Ibrashige/Sunstation/Research/Early PCB Design & Schematics/Base model Design & Schematics/PCB_Final base model copy_2020-09-08_11-15-57.png

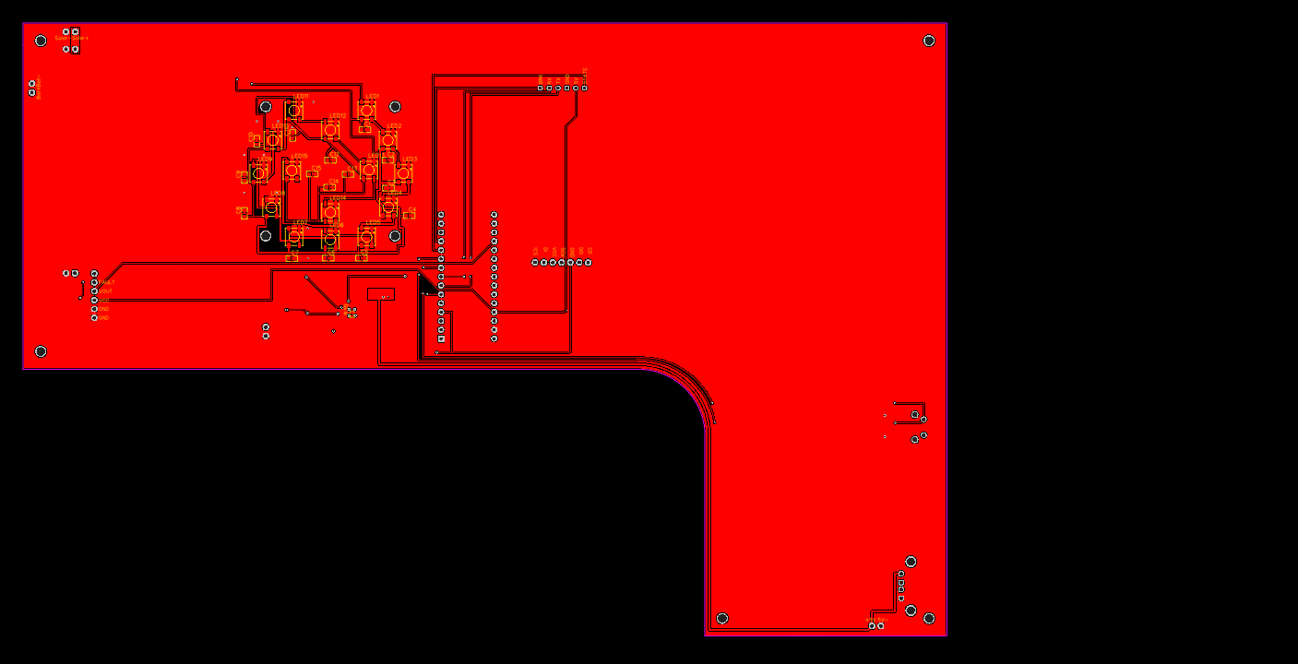
Research/Early PCB Design & Schematics/Base model Design & Schematics/PCB_Final base model copy_2020-09-08_11-15-57.png
