Ibrashige/Sunstation/Research/Early PCB Design & Schematics/Base model Design & Schematics/PCB_Final base model copy_2020-09-08_11-16-11.png

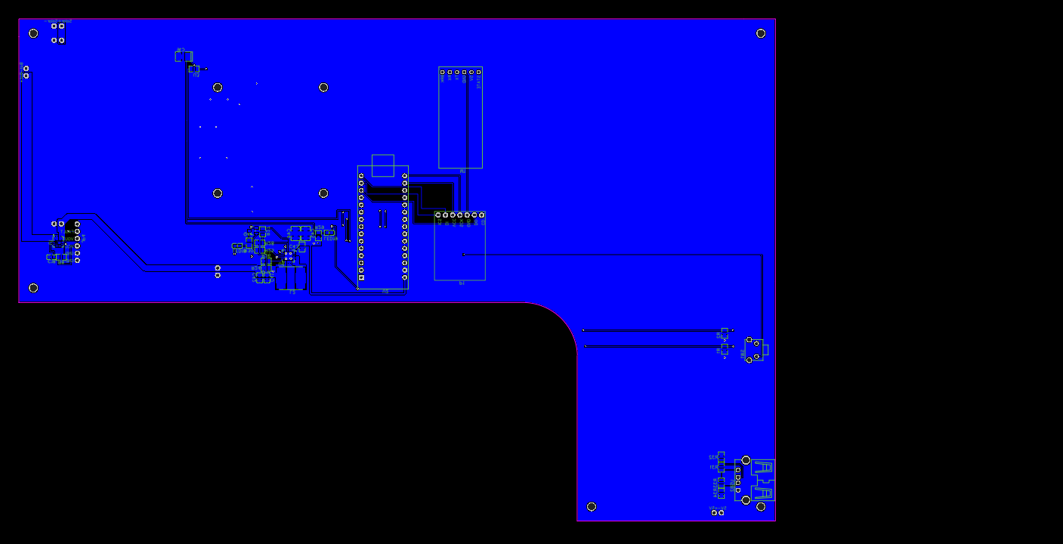
Research/Early PCB Design & Schematics/Base model Design & Schematics/PCB_Final base model copy_2020-09-08_11-16-11.png
