Ibrashige/Sunstation/Research/Early PCB Design & Schematics/Base model Design & Schematics/Schematic_Final base model_2020-09-08_11-15-40.png

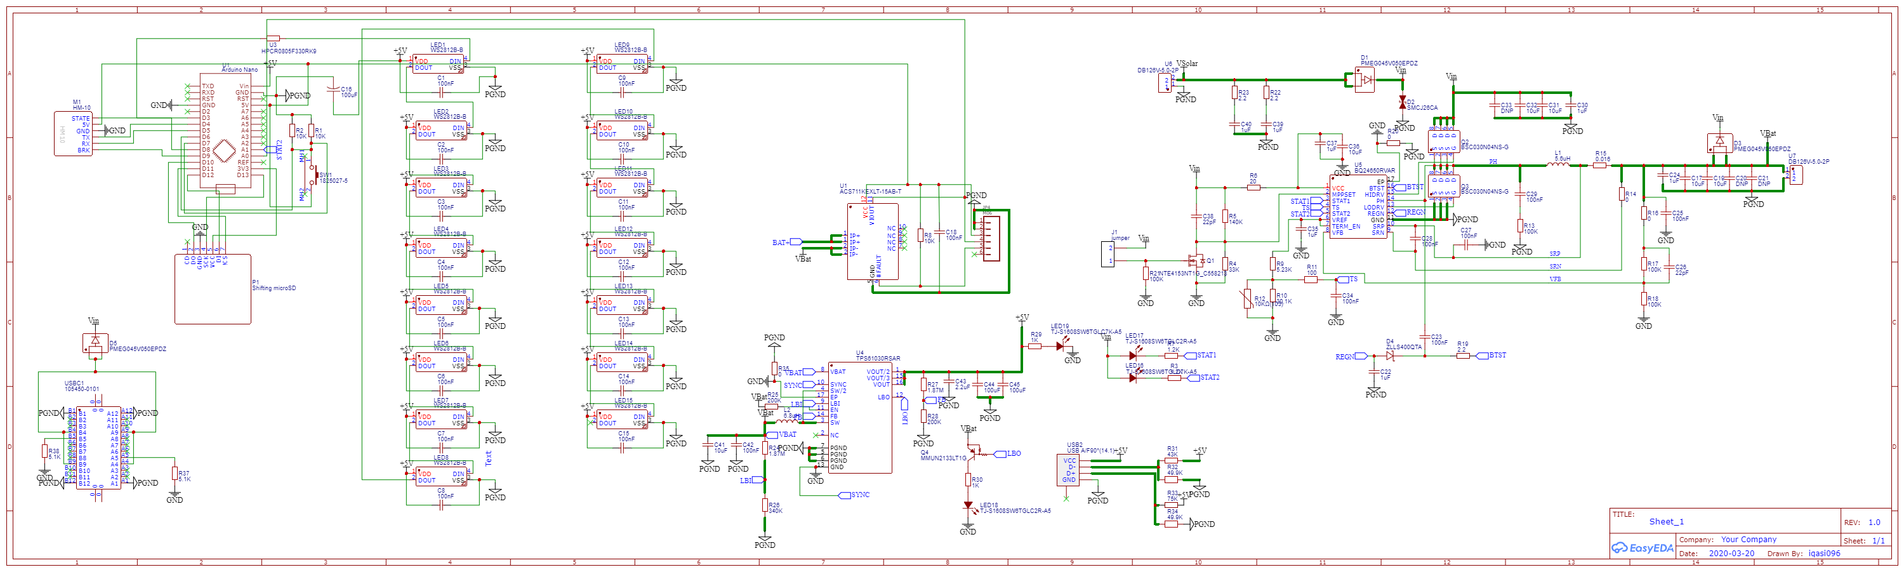
Research/Early PCB Design & Schematics/Base model Design & Schematics/Schematic_Final base model_2020-09-08_11-15-40.png
