Ibrashige/Sunstation/Research/Early PCB Design & Schematics/LED Display  Design & Schematics/PCB_6 segment sunstation PCB copy copy_2020-09-08_11-02-25.png

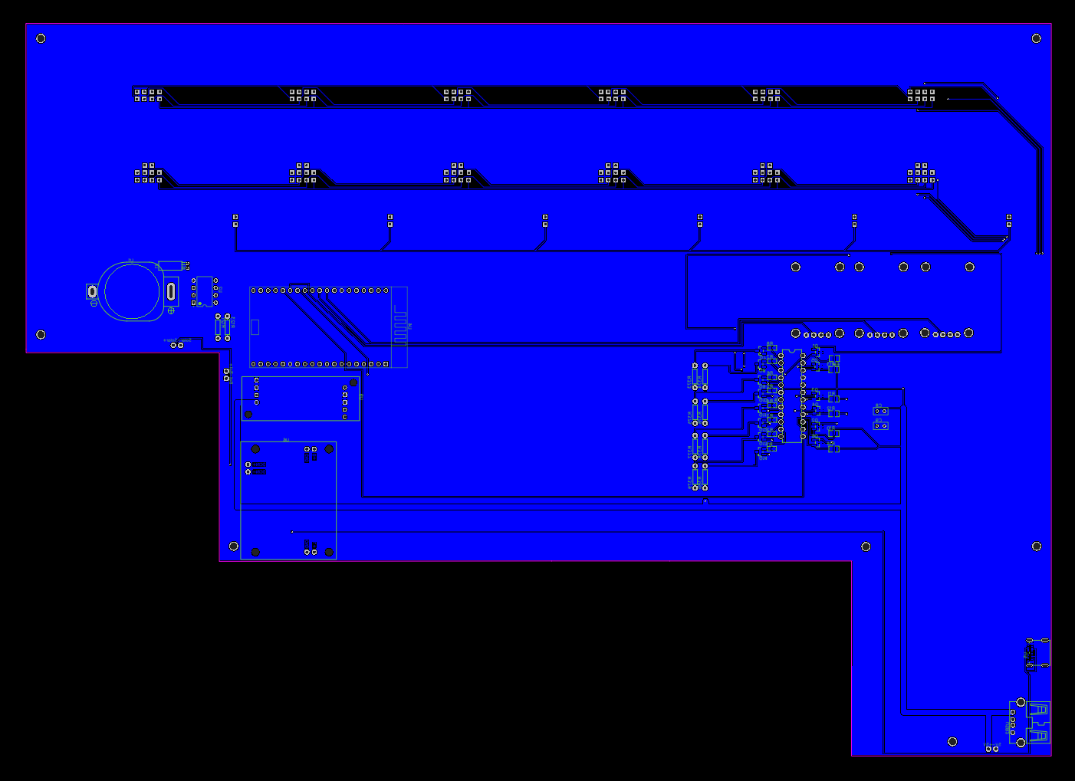
Research/Early PCB Design & Schematics/LED Display Design & Schematics/PCB_6 segment sunstation PCB copy copy_2020-09-08_11-02-25.png
