Ibrashige/Sunstation/Research/Early PCB Design & Schematics/LED Display  Design & Schematics/Schematic_LED mock up_2020-09-08_11-03-54.png

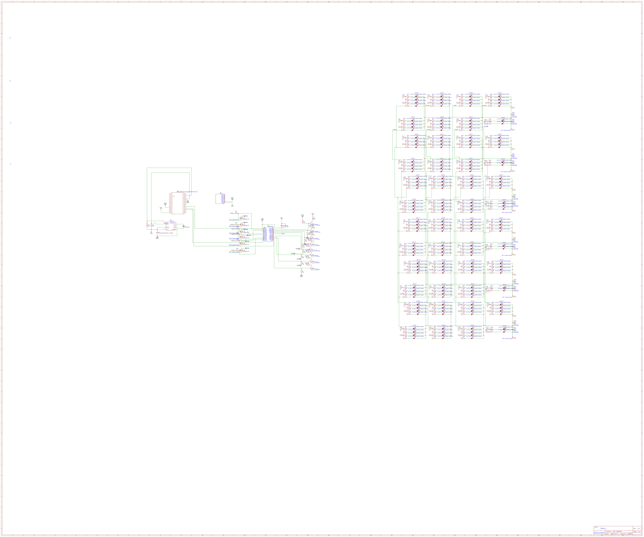
Research/Early PCB Design & Schematics/LED Display Design & Schematics/Schematic_LED mock up_2020-09-08_11-03-54.png
