Ibrashige/Sunstation/Research/Early PCB Design & Schematics/Power Electronics Design & Schematics/PCB_Sunstation Board copy_2020-09-08_11-18-07.png

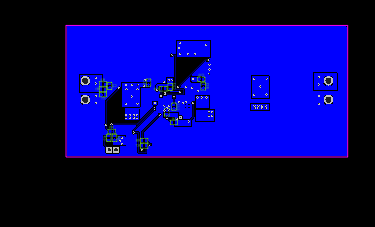
Research/Early PCB Design & Schematics/Power Electronics Design & Schematics/PCB_Sunstation Board copy_2020-09-08_11-18-07.png
