Ibrashige/Sunstation/Research/Early PCB Design & Schematics/Power Electronics Design & Schematics/Schematic_Fixed BQ24650EVM_2020-09-08_11-17-46.png

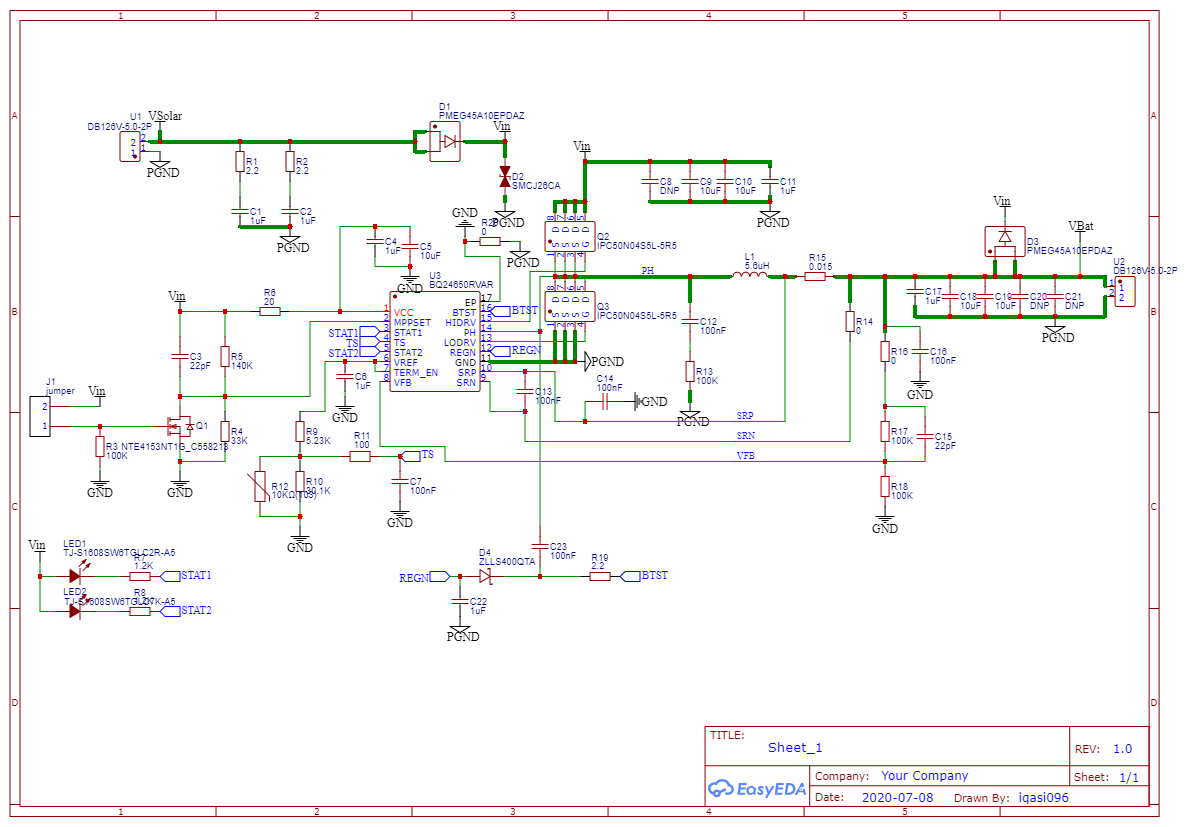
Research/Early PCB Design & Schematics/Power Electronics Design & Schematics/Schematic_Fixed BQ24650EVM_2020-09-08_11-17-46.png
