Ibrashige/Sunstation/Research/LED Display Research/12 Digit 7 segment LED Display/12digit_7segment.PNG

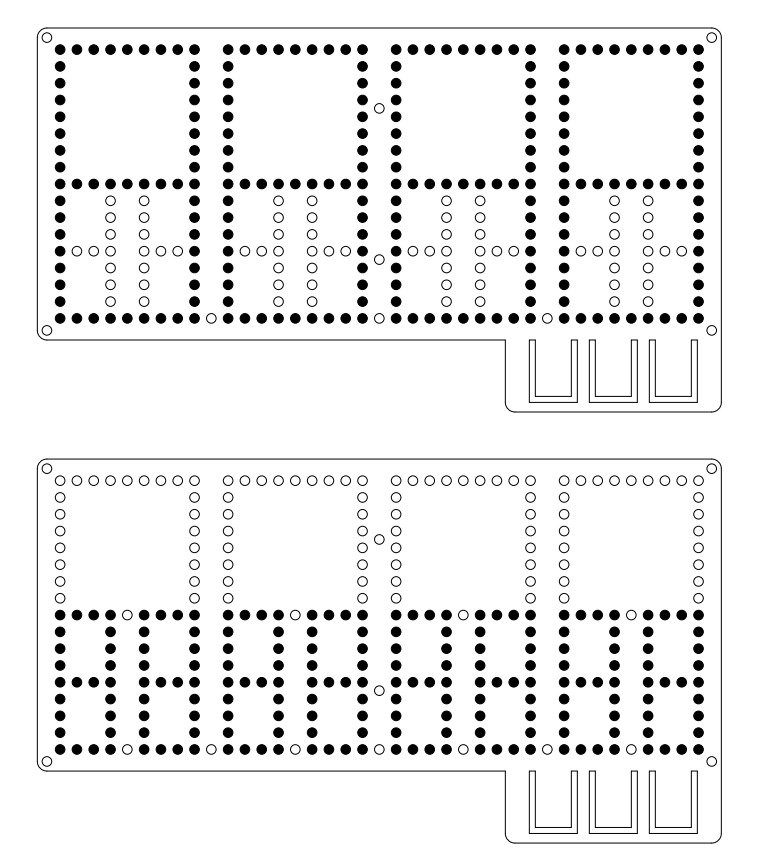
Research/LED Display Research/12 Digit 7 segment LED Display/12digit_7segment.PNG
