Ibrashige/Sunstation/Research/LED Display Research/Single 7 segment Digit LED Display/binary_representation.jpg

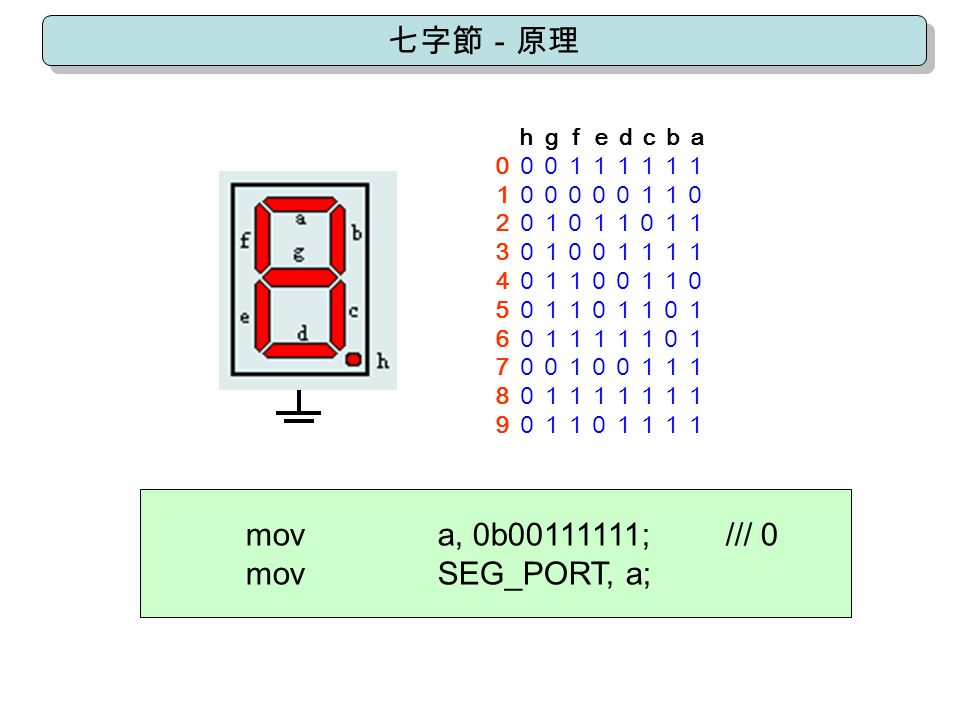
Research/LED Display Research/Single 7 segment Digit LED Display/binary_representation.jpg
