Ibrashige/Sunstation/Research/LED Display Research/Single 7 segment Digit LED Display/digits.jpg

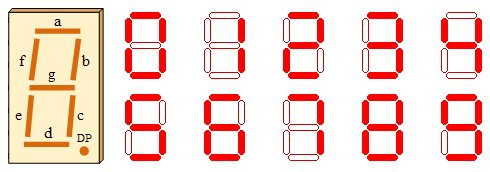
Research/LED Display Research/Single 7 segment Digit LED Display/digits.jpg
