Ibrashige/Sunstation/BOM CPL & Gerbers/Base Model/BOM_Final base model_2021-08-13.csv.xlsx

ID | Name | Designator | Footprint | Quantity | Manufacturer Part | Manufacturer | Supplier | Supplier Part | Price | Links
1 | 100nF | C1,C2,C3,C4,C5,C6,C7,C8,C9,C10,C11,C12,C13,C14,C15,C18 | C0603 | 16 | C0603C104K5RACAUTO | KEMET | LCSC | C129621 | $0.01 | https://lcsc.com/product-detail/Multilayer-Ceramic-Capacitors-MLCC-SMD-SMT_KEMET-C0603C104K5RACAUTO_C129621.html
2 | 100uF | C16 | CAP-SMD_L3.5-W2.8 | 1 | CA45-B-10V-100uF-M | Shenzhen Zhenhua XinYun Elec | LCSC | C140381 | $0.30 | https://lcsc.com/product-detail/Tantalum-Capacitors_CEC-Shenzhen-Zhenhua-XinYun-Elec-CA45-B-10V-100uF-M_C140381.html
3 | 10uF | C17,C19,C31,C32,C36 | C0402 | 5 | GRM155R61A106ME21D | Murata Electronics | LCSC | C324476 | $0.02 | https://lcsc.com/product-detail/Multilayer-Ceramic-Capacitors-MLCC-SMD-SMT_Murata-Electronics-GRM155R61A106ME21D_C324476.html
4 | DNP | C20,C21,C33 | C0402 | 3 | GRM155R61A106ME21D | Murata Electronics | LCSC | C324476 | $0.02
5 | 1uF | C22,C24,C30,C35,C37,C39,C40 | C0402 | 7 | 0402B105K100NT | FH | LCSC | C1526 | $0.003 | https://lcsc.com/product-detail/Multilayer-Ceramic-Capacitors-MLCC-SMD-SMT_FH-Guangdong-Fenghua-Advanced-Tech-0402B105K100NT_C1526.html
6 | 100nF | C23,C25,C27,C28,C29,C34 | C0402 | 6 | GRM155R71C104KA88D | MuRata | LCSC | C71629 | $0.002 | https://lcsc.com/product-detail/Multilayer-Ceramic-Capacitors-MLCC-SMD-SMT_Murata-Electronics-GRM155R71C104KA88D_C71629.html
7 | 22pF | C26,C38 | C0402 | 2 | GRM1555C1H220JA01D | MuRata | LCSC | C76960 | $0.004 | https://lcsc.com/product-detail/Multilayer-Ceramic-Capacitors-MLCC-SMD-SMT_Murata-Electronics-GRM1555C1H220JA01D_C76960.html
8 | 100nF | C51 | C0603 | 1 | AC0603KRX7R9BB104 | YAGEO | LCSC | C149620 | $0.01 | https://lcsc.com/product-detail/Multilayer-Ceramic-Capacitors-MLCC-SMD-SMT_YAGEO-AC0603KRX7R9BB104_C149620.html
9 | B2P-VH-FB-B-(LF)(SN) | CN1 | CONN-TH_2P-P3.96_B2P-VH-FB-B(LF)(SN) | 1 | B2P-VH-FB-B-(LF)(SN) | JST Sales America | LCSC | C158006 | $0.14 | https://lcsc.com/product-detail/Wire-To-Board-Wire-To-Wire-Connector_JST-Sales-America-B2P-VH-FB-B-LF-SN_C158006.html
10 | PMEG45A10EPDAZ | D1,D3 | SOT1289_L5.8-W4.4-LS6.5-RD | 2 | PMEG45A10EPDAZ | Nexperia | LCSC | C458256 | $0.83 | https://lcsc.com/product-detail/Schottky-Barrier-Diodes-SBD_Nexperia-PMEG45A10EPDAZ_C458256.html
11 | SMCJ26CA | D2 | SMC_L6.9-W5.9-LS7.9-BI | 1 | SMCJ26CA | RUILON | LCSC | C10244 | $0.21 | https://lcsc.com/product-detail/TVS_RUILON-Shenzhen-Ruilongyuan-Elec-SMCJ26CA_C10244.html
12 | ZLLS400QTA | D4 | SOD-323_L1.8-W1.3-LS2.5-RD | 1 | ZLLS400QTA | DIODES | LCSC | C151560 | $0.23 | https://lcsc.com/product-detail/Schottky-Barrier-Diodes-SBD_Diodes-Incorporated-ZLLS400QTA_C151560.html
13 | 5.6uH | L1 | IND-SMD_L11.5-W10.0_APS10A40 | 1 | APS10A40M5R6 | COILANK INTERNATIONAL | LCSC | C253624 | $0.29 | https://lcsc.com/product-detail/Power-Inductors_COILANK-INTERNATIONAL-APS10A40M5R6_C253624.html
14 | WS2812B-B | LED1,LED2,LED3,LED4,LED5,LED6,LED7,LED8,LED9,LED10,LED11,LED12,LED13,LED14 | LED-SMD_4P-L5.0-W5.0-BL | 14 | WS2812B-B | Worldsemi | LCSC | C114586 | $0.11 | https://lcsc.com/product-detail/Light-Emitting-Diodes-LED_Worldsemi-WS2812B-B_C114586.html
15 | WS2812B-B | LED15 | LED-SMD_4P-L5.0-W5.0-BL | 1 | WS2812B-B | Worldsemi | LCSC | C114586 | $0.11 | https://lcsc.com/product-detail/Light-Emitting-Diodes-LED_Worldsemi-WS2812B-B_C114586.html
16 | TJ-S1608SW6TGLC7K-A5 | LED16 | LED0603-R-RD | 1 | TJ-S1608SW6TGLC7K-A5 | TOGIALED | LCSC | C192666 | $0.03 | https://lcsc.com/product-detail/Light-Emitting-Diodes-LED_TOGIALED-TJ-S1608SW6TGLC7K-A5_C192666.html
17 | HL-798H256WC-MD_TC=6500K | LED17 | LED-TH_BD5.8-P2.54-R-RD | 1 | HL-798H256WC-MD_TC=6500K | HONGLITRONIC(Hongli Zhihui (HONGLITRONIC)) | LCSC | C568949 | $0.07 | https://lcsc.com/product-detail/Light-Emitting-Diodes-LED_HONGLITRONIC-Hongli-Zhihui-HONGLITRONIC-HL-798H256WC-MD_TC-6500K_C568949.html
18 | HM-10 | M1 | HM-10-MODULE | 1 |  |  |  | undefined
19 | NTE4153NT1G_C558213 | Q1 | SC-75-3_L1.6-W0.8-P1.00-LS1.6-BR | 1 | NTE4153NT1G | VBsemi Elec | LCSC | C558213 | $0.06 | https://lcsc.com/product-detail/MOSFETs_VBsemi-Elec-NTE4153NT1G_C558213.html
20 | IPC50N04S5L-5R5 | Q2,Q3 | PG-TDSON-8-FL_L5.0-W6.0-P1.27-LS6.2-BL | 2 | IPC50N04S5L-5R5 | Infineon Technologies | LCSC | C536703 | $1.03 | https://lcsc.com/product-detail/MOSFETs_Infineon-Technologies-IPC50N04S5L-5R5_C536703.html
21 | VBM2610N | Q4,Q5 | ITO-220AB-3_L10.2-W4.5-P2.60-L | 2 | VBM2610N | VBsemi Elec | LCSC | C481026 | $0.56 | https://lcsc.com/product-detail/MOSFETs_VBsemi-Elec-VBM2610N_C481026.html
22 | 10K | R1,R2,R8,R25,R26 | R0805 | 5 | CR0805J80103G | LIZ | LCSC | C101926 | $0.002 | https://lcsc.com/product-detail/Chip-Resistor-Surface-Mount_LIZ-Elec-CR0805J80103G_C101926.html
23 | 1.2K | R3,R7 | R0402 | 2 | AC0402FR-071K2L | YAGEO | LCSC | C144793 | $0.001 | https://lcsc.com/product-detail/Chip-Resistor-Surface-Mount_YAGEO-AC0402FR-071K2L_C144793.html
24 | 33K | R4 | R0402 | 1 | AC0402FR-0733KL | YAGEO | LCSC | C138291 | $0.001 | https://lcsc.com/product-detail/Chip-Resistor-Surface-Mount_YAGEO-AC0402FR-0733KL_C138291.html
25 | 140K | R5 | R0402 | 1 | RC0402FR-07140KL | YAGEO | LCSC | C114151 | $0.001 | https://lcsc.com/product-detail/Chip-Resistor-Surface-Mount_YAGEO-RC0402FR-07140KL_C114151.html
26 | 20 | R6 | R0402 | 1 | CR0402FF20R0G | LIZ | LCSC | C100299 | $0.001 | https://lcsc.com/product-detail/Chip-Resistor-Surface-Mount_LIZ-Elec-CR0402FF20R0G_C100299.html
27 | 5.23K | R9 | R0402 | 1 | 0402WGF5231TCE | UniOhm | LCSC | C25907 | $0.001 | https://lcsc.com/product-detail/Chip-Resistor-Surface-Mount_UNI-ROYAL-Uniroyal-Elec-0402WGF5231TCE_C25907.html
28 | 30.1K | R10 | R0402 | 1 | 0402WGF3012TCE | UniOhm | LCSC | C29402 | $0.001 | https://lcsc.com/product-detail/Chip-Resistor-Surface-Mount_UNI-ROYAL-Uniroyal-Elec-0402WGF3012TCE_C29402.html
29 | 100 | R11 | R0402 | 1 | 0402WGD1000TCE | Uniroyal Elec | LCSC | C407755 | $0.003 | https://lcsc.com/product-detail/Chip-Resistor-Surface-Mount_UNI-ROYAL-Uniroyal-Elec-0402WGD1000TCE_C407755.html
30 | 10KΩ | R12 | RES-TH_L8.0-W2.8-P2.54-D0-6 | 1 | NTCLE101E3C90173 | VISHAY | LCSC | C143692 | $1.74 | https://lcsc.com/product-detail/NTC-Thermistors_Vishay-Intertech-NTCLE101E3C90173_C143692.html
31 | 100K | R13,R17,R18,R21 | R0402 | 4 | AC0402FR-07100KL | YAGEO | LCSC | C144809 | $0.001 | https://lcsc.com/product-detail/Chip-Resistor-Surface-Mount_YAGEO-AC0402FR-07100KL_C144809.html
32 | 0 | R14,R16,R20 | R0402 | 3 | RC0402JR-070RL | YAGEO | LCSC | C60485 | $0.001 | https://lcsc.com/product-detail/Chip-Resistor-Surface-Mount_YAGEO-RC0402JR-070RL_C60485.html
33 | 0.015 | R15 | R1210 | 1 | CR1210F0R015P05 | Ever Ohms Tech | LCSC | C147206 | $0.03 | https://lcsc.com/product-detail/Current-Sense-Resistors-Shunt-Resistors_Ever-Ohms-Tech-CR1210FR015P05Z_C147206.html
34 | 2.2 | R19,R22,R23 | R0402 | 3 | 0402WGF220KTCE | UniOhm | LCSC | C25101 | $0.001 | https://lcsc.com/product-detail/Chip-Resistor-Surface-Mount_UNI-ROYAL-Uniroyal-Elec-0402WGF220KTCE_C25101.html
35 | 10M | R24 | R1206 | 1 | 1206W4F1005T5E | UniOhm | LCSC | C26119 | $0.01 | https://lcsc.com/product-detail/Chip-Resistor-Surface-Mount_UNI-ROYAL-Uniroyal-Elec-1206W4F1005T5E_C26119.html
36 | 43K | R31 | R0805 | 1 | WR08X4302FTL | WTC | LCSC | C168454 | $0.01 | https://lcsc.com/product-detail/Chip-Resistor-Surface-Mount_Walsin-Tech-Corp-WR08X4302FTL_C168454.html
37 | 49.9K | R32,R34 | R0805 | 2 | ERJ6ENF4992V | PANASONIC | LCSC | C416856 | $0.01 | https://lcsc.com/product-detail/Chip-Resistor-Surface-Mount_PANASONIC-ERJ6ENF4992V_C416856.html
38 | 75K | R33 | R0805 | 1 | 0805W8F7502T5E | UniOhm | LCSC | C17819 | $0.003 | https://lcsc.com/product-detail/Chip-Resistor-Surface-Mount_UNI-ROYAL-Uniroyal-Elec-0805W8F7502T5E_C17819.html
39 | 154K | R37 | R0603 | 1 | ERJ3EKF1543V | PANASONIC | LCSC | C403000 | $0.01 | https://lcsc.com/product-detail/Chip-Resistor-Surface-Mount_PANASONIC-ERJ3EKF1543V_C403000.html
40 | 21.3K | R46 | R0603 | 1 | CR0603-FX-2102ELF | BOURNS | LCSC | C203401 | $0.01 | https://lcsc.com/product-detail/Chip-Resistor-Surface-Mount_BOURNS-CR0603-FX-2102ELF_C203401.html
41 | 100K | R47 | R0603 | 1 | RMC16K104FTP | KAMAYA | LCSC | C323555 | $0.003 | https://lcsc.com/product-detail/Chip-Resistor-Surface-Mount_KAMAYA-RMC16K104FTP_C323555.html
42 | 1825027-5 | SW1 | KEY-TH_4P-L7.5-W6.8-P4.50-LS7.2 | 1 | 1825027-5 | TE Connectivity | LCSC | C86476 | $0.12 | https://lcsc.com/product-detail/Tactile-Switches_TE-Connectivity-1825027-5_C86476.html
43 | ACS711KEXLT-15AB-T |  |  | 1 | ACS711KEXLT-15AB-T | Allegro MicroSystems, LLC | Pololu
44 | Arduino Nano | U2 | ARDUINO_NANO1 | 1 | arduino_nano1
45 | HPCR0805F330RK9 | U3 | R0805 | 1 | HPCR0805F330RK9 | ResistorToday | LCSC | C365291 | $0.04 | https://lcsc.com/product-detail/Chip-Resistor-Surface-Mount_Resistor-Today-HPCR0805F330RK9_C365291.html
46 | U3V70F15 | U4 | U3V70X FOOTPRINT | 1 | 2896 | Pololu | Pololu | 2896
47 | BQ24650RVAR | U5 | VQFN-16_L3.6-W3.6-P0.50-BL-EP | 1 | BQ24650RVAR | TI | LCSC | C53712 | $2.85 | https://lcsc.com/product-detail/Battery-Management-ICs_Texas-Instruments-BQ24650RVAR_C53712.html
48 | DB126V-5.0-2P | U7 | CONN-TH_2P-P5.00_L7.8-W10.0 | 1 | DB126V-5.0-2P | DIBO | LCSC | C395849 | $0.08
49 | TPS3700DDCR | U9 | SOT-23-6_L2.9-W1.6-P0.95-LS2.8-BL | 1 | TPS3700DDCR | TI | LCSC | C33002 | $1.31 | https://lcsc.com/product-detail/Comparators_Texas-Instruments-TPS3700DDCR_C33002.html
50 | USB A/F90°(14.1) | USB2 | USB-A-TH_USB-M-1 | 1 | USB A/F90°(14.1) | ValuePro | LCSC | C2344 | $0.04 | https://lcsc.com/product-detail/USB-Connectors_Jing-Extension-of-the-Electronic-Co-902-131A1021D10100_C2344.html
51 | 105450-0101 | USBC1 | USB-C-SMD_TYPE-C-USB-18 | 1 | 105450-0101 | MOLEX | LCSC | C134092 | $0.63 | https://lcsc.com/product-detail/USB-Connectors_MOLEX-1054500101_C134092.html
