Ibrashige/Sunstation/Research/Early BOM CPL & Gerbers/Base Model/BOM_Final base model_2020-09-08_11-41-40.csv

ID | Name | Designator | Footprint | Quantity | Manufacturer Part | Manufacturer | Supplier | Supplier Part | LCSC Assembly
1 | M06 | JP4 | 1X06 | 1
2 | ZLLS400QTA | D4 | SOD-323_L1.8-W1.3-LS2.5-RD | 1 | ZLLS400QTA | DIODES | LCSC | C151560 | Yes
3 | TJ-S1608SW6TGLC7K-A5 | LED16,LED19 | LED0603-R-RD | 2 | TJ-S1608SW6TGLC7K-A5 | TOGIALED | LCSC | C192666
4 | 100nF | C7,C1,C2,C3,C4,C5,C6,C8,C9,C10,C11,C12,C13,C14,C15,C18 | C0603 | 16 | C0603C104K5RACAUTO | KEMET | LCSC | C129621
5 | 1uF | C22,C24,C30,C35,C37,C39,C40 | C0402 | 7 | 0402B105K100NT | FH | LCSC | C1526
6 | 5.1K | R37,R38 | R0805 | 2 | RMC08055.1K5%N | Tyohm | LCSC | C269736
7 | 2.2 | R19,R22,R23 | R0402 | 3 | 0402WGF220KTCE | UniOhm | LCSC | C25101 | Yes
8 | 10KΩ(103) | R12 | R0805 | 1 | NCP21XV103J03RA | MuRata | LCSC | C73681
9 | 1.2K | R3,R7 | R0402 | 2 | AC0402FR-071K2L | YAGEO | LCSC | C144793
10 | NTE4153NT1G_C558213 | Q1 | SC-75-3_L1.6-W0.8-P1.00-LS1.6-BR | 1 | NTE4153NT1G | VBsemi Elec | LCSC | C558213
11 | WS2812B-B | LED1,LED2,LED3,LED4,LED5,LED6,LED7,LED8,LED9,LED10,LED11,LED12,LED13,LED14,LED15 | LED-SMD_4P-L5.0-W5.0-BL | 15 | WS2812B-B | Worldsemi | LCSC | C114586 | Yes
12 | 1K | R29,R30 | R0805 | 2 | RMC08051K5%N | Tyohm | LCSC | C269727
13 | 100 | R11 | R0402 | 1 | 0402WGD1000TCE | Uniroyal Elec | LCSC | C407755
14 | 0 | R20,R16,R14,R35 | R0402 | 4 | RC0402JR-070RL | YAGEO | LCSC | C60485
15 | HM-10 | M1 | HM-10-MODULE | 1 |  |  |  | undefined
16 | 100K | R18,R17,R13,R21 | R0402 | 4 | AC0402FR-07100KL | YAGEO | LCSC | C144809
17 | 75K | R33 | R0805 | 1 | 0805W8F7502T5E | UniOhm | LCSC | C17819 | Yes
18 | HPCR0805F330RK9 | U3 | R0805 | 1 | HPCR0805F330RK9 | ResistorToday | LCSC | C365291
19 | MMUN2133LT1G | Q4 | SOT-23-3_L2.9-W1.6-P1.90-LS2.8-BR | 1 | MMUN2133LT1G | ON | LCSC | C86182 | Yes
20 | 5.6uH | L1 | IND-SMD_L11.5-W10.0_APS10A40 | 1 | APS10A40M5R6 | COILANK INTERNATIONAL | LCSC | C253624
21 | TJ-S1608SW6TGLC2R-A5 | LED17,LED18 | LED0603-R-RD | 2 | TJ-S1608SW6TGLC2R-A5 | TOGIALED | LCSC | C192315
22 | TPS61030RSAR | U4 | QFN-16_L4.0-W4.0-P0.65-TL-EP2.6 | 1 | TPS61030RSAR | TI | LCSC | C10110 | Yes
23 | 33K | R4 | R0402 | 1 | AC0402FR-0733KL | YAGEO | LCSC | C138291
24 | 1.87M | R24,R27 | R0805 | 2 | RS-05L1874FT | Guangdong Fenghua Advanced Tech | LCSC | C320616
25 | BSC030N04NS-G | Q3,Q2 | PG-TDSON-8_L5.0-W6.0-P1.27-LS6.2-BL-EP | 2 | BSC030N04NS-G | Infineon Technologies | LCSC | C386365
26 | 340K | R26 | R0805 | 1 | RMC0805340K1%N | Tyohm | LCSC | C269564
27 | 6.8uH | L2 | IND-SMD_L8.0-W8.0 | 1 | ASPI-8040S-6R8N-T | Abracon LLC | LCSC | C187477
28 | 30.1K | R10 | R0402 | 1 | 0402WGF3012TCE | UniOhm | LCSC | C29402 | Yes
29 | 100nF | C23,C25,C27,C28,C29,C34 | C0402 | 6 | GRM155R71C104KA88D | MuRata | LCSC | C71629
30 | 1825027-5 | SW1 | KEY-TH_4P-L7.5-W6.8-P4.50-LS7.2 | 1 | 1825027-5 | TE Connectivity | LCSC | C86476
31 | PMEG045V050EPDZ | D3,D1,D5 | SOT1289_L5.8-W4.4-LS6.5-RD | 3 | PMEG045V050EPDZ | Nexperia | LCSC | C458162
32 | DB126V-5.0-2P | U6,U7 | CONN-TH_2P-P5.00_L7.8-W10.0 | 2 | DB126V-5.0-2P | DIBO | LCSC | C395849
33 | 10K | R1,R2,R8 | R0805 | 3 | CR0805J80103G | LIZ | LCSC | C101926
34 | ACS711KEXLT-15AB-T | U1 | IC-SMD_ACS711KEXLT-15AB-T | 1 | ACS711KEXLT-15AB-T | Allegro MicroSystems, LLC | LCSC | C150824
35 | 105450-0101 | USBC1 | USB-C-SMD_TYPE-C-USB-18 | 1 | 105450-0101 | MOLEX | LCSC | C134092
36 | 140K | R5 | R0402 | 1 | RC0402FR-07140KL | YAGEO | LCSC | C114151
37 | jumper | J1 | JUMPER | 1
38 | 100uF | C44,C45 | C1210 | 2 | LMK325BJ107MM-T | TAIYO YUDEN | LCSC | C92822
39 | 10uF | C41 | C0805 | 1 | CL21A106KPFNNNE | SAMSUNG | LCSC | C17024
40 | BQ24650RVAR | U5 | VQFN-16_L3.6-W3.6-P0.50-BL-EP | 1 | BQ24650RVAR | TI | LCSC | C53712 | Yes
41 | 2.2uF | C43 | C0805 | 1 | 0805X225K250NT | FH | LCSC | C105486
42 | 100uF | C16 | CAP-SMD_L3.5-W2.8 | 1 | CA45-B-10V-100uF-M | Shenzhen Zhenhua XinYun Elec | LCSC | C140381 | Yes
43 | 49.9K | R32,R34 | R0805 | 2 | ERJ6ENF4992V | PANASONIC | LCSC | C416856
44 | 0.016 | R15 | R1210 | 1 | CR1210J0R016P05 | Ever Ohms Tech | LCSC | C175886
45 | DNP | C21,C20,C33 | C0402 | 3 | GRM155R61A106ME21D | Murata Electronics | LCSC | C324476
46 | 10uF | C19,C17,C31,C32,C36 | C0402 | 5 | GRM155R61A106ME21D | Murata Electronics | LCSC | C324476
47 | 22pF | C26,C38 | C0402 | 2 | GRM1555C1H220JA01D | MuRata | LCSC | C76960
48 | 5.23K | R9 | R0402 | 1 | 0402WGF5231TCE | UniOhm | LCSC | C25907 | Yes
49 | Shifting microSD | P1 | SHIFTING MICROSD | 1
50 | 200K | R25,R28 | R0805 | 2 | RC0805FR-07200KL | YAGEO | LCSC | C114562
51 | USB A/F90°(14.1) | USB2 | USB-A-TH_USB-M-1 | 1 | USB A/F90°(14.1) | ValuePro | LCSC | C2344
52 | 100nF | C42 | C0805 | 1 | 0805B104K500NT | FH | LCSC | C38141
53 | 20 | R6 | R0402 | 1 | CR0402FF20R0G | LIZ | LCSC | C100299
54 | Arduino Nano | U2 | ARDUINO_NANO1 | 1 | arduino_nano1
55 | 43K | R31 | R0805 | 1 | WR08X4302FTL | WTC | LCSC | C168454
56 | SMCJ26CA | D2 | SMC_L6.9-W5.9-LS7.9-BI | 1 | SMCJ26CA | RUILON | LCSC | C10244 | Yes
