Ibrashige/Sunstation/Research/Early BOM CPL & Gerbers/LED Display/BOM_LED mock up_2020-09-08_11-47-22.csv

ID | Name | Designator | Footprint | Quantity | Manufacturer Part | Manufacturer | Supplier | Supplier Part | LCSC Assembly
1 | LBSS84LT1G | Q1,Q2,Q3,Q4,Q5,Q6 | SOT-23_L2.9-W1.3-P0.95-LS2.4-BR | 6 | LBSS84LT1G | LRC | LCSC | C8492 | Yes
2 | DS1307+ | U2 | DIP-8_L9.8-W6.6-P2.54-LS7.6-BL | 1 | DS1307+ | MAXIM | LCSC | C59267
3 | IDC_8 | U7 | IDC381-8-110/KRONE | 1 |  | bd
4 | 1K | R9,R10,R11,R12,R13,R14 | R0805 | 6 | 0805W8F1001T5E | UniOhm | LCSC | C17513 | Yes
5 | ESP32-DEVKITC-32D_ESP32-DEVKITC-32D | U4 | MODULE_ESP32-DEVKITC-32D | 1
6 | BC2032-E2 BATTERY HOLDER | U1 | BC2013-E2 BATTERY HOLDER | 1
7 | HL-PC-3216H233W(9000-16000K) | LED164,LED163,LED162,LED165,LED204,LED203,LED202,LED205,LED268,LED267,LED266,LED269,LED324,LED323,LED322,LED325,LED132,LED131,LED130,LED133,LED208,LED207,LED206,LED209,LED272,LED271,LED270,LED273,LED351,LED350,LED168,LED167,LED166,LED169,LED212,LED211,LED210,LED213,LED276,LED275,LED274,LED277,LED328,LED327,LED326,LED329,LED136,LED135,LED134,LED137,LED216,LED215,LED214,LED217,LED280,LED279,LED278,LED281,LED353,LED352,LED172,LED171,LED170,LED173,LED220,LED219,LED218,LED221,LED284,LED283,LED282,LED285,LED332,LED331,LED330,LED333,LED140,LED139,LED138,LED141,LED224,LED223,LED222,LED225,LED288,LED287,LED286,LED289,LED355,LED354,LED176,LED175,LED174,LED177,LED228,LED227,LED226,LED229,LED292,LED291,LED290,LED293,LED336,LED335,LED334,LED337,LED144,LED143,LED142,LED145,LED232,LED231,LED230,LED233,LED296,LED295,LED294,LED297,LED357,LED356,LED181,LED178,LED179,LED180,LED237,LED234,LED235,LED236,LED301,LED298,LED299,LED300,LED341,LED338,LED339,LED340,LED149,LED146,LED147,LED148,LED241,LED238,LED239,LED240,LED305,LED302,LED303,LED304,LED358,LED359,LED185,LED182,LED183,LED184,LED245,LED242,LED243,LED244,LED309,LED306,LED307,LED308,LED345,LED342,LED343,LED344,LED153,LED150,LED151,LED152,LED249,LED246,LED247,LED248,LED313,LED310,LED311,LED312,LED360,LED361,LED372 | LED1206-R-RD | 181 | HL-PC-3216H233W(9000-16000K) | Hongli Zhihui (HONGLITRONIC) | LCSC | C219232
8 | Header-Male-2.54_1x1 | P229,P232,P198,P206,P168,P136,P94,P166,P134,P110,P197,P135,P109,P167,P133,P165,P205,P93,P231,P230,P234,P235,P95,P207,P169,P137,P171,P111,P139,P199,P112,P138,P170,P96,P140,P172,P208,P200,P236,P233,P238,P239,P97,P209,P173,P141,P175,P113,P143,P201,P114,P142,P174,P98,P144,P176,P210,P202,P240,P237,P242,P243,P99,P211,P177,P145,P179,P115,P147,P203,P116,P146,P178,P100,P148,P180,P212,P204,P244,P241,P222,P223,P89,P193,P157,P125,P159,P105,P127,P185,P106,P126,P158,P90,P128,P160,P194,P186,P224,P221,P226,P227,P91,P195,P161,P129,P163,P107,P131,P187,P108,P130,P162,P92,P132,P164,P196,P188,P228,P225 | HDR-1X1/2.54 | 120 | Header-Male-2.54_1x1 | ReliaPro | LCSC | C81276
9 | 10k | R123,R121,R15,R16,R17,R18,R19,R20,R21,R22 | AXIAL-0.3 | 10
10 | 1k | R296,R297,R298,R299,R232,R233,R234,R235,R151,R150,R149,R148,R359,R358,R357,R356,R295,R294,R293,R292,R228,R229,R230,R231,R348,R349,R183,R182,R181,R180,R184,R185,R186,R187,R351,R350,R239,R238,R237,R236,R300,R301,R302,R303,R360,R361,R362,R363,R152,R153,R154,R155,R243,R242,R241,R240,R307,R306,R305,R304,R188,R189,R190,R191,R353,R352,R247,R246,R245,R244,R308,R309,R310,R311,R364,R365,R366,R367,R156,R157,R158,R159,R251,R250,R249,R248,R315,R314,R313,R312,R192,R193,R194,R195,R355,R354,R255,R254,R253,R252,R316,R317,R318,R319,R368,R369,R370,R371,R160,R161,R162,R163,R259,R258,R257,R256,R323,R322,R321,R320,R172,R173,R174,R175,R329,R328,R215,R214,R213,R212,R276,R277,R278,R279,R340,R341,R342,R343,R140,R141,R142,R143,R219,R218,R217,R216,R283,R282,R281,R280,R176,R177,R178,R179,R331,R330,R223,R222,R221,R220,R284,R285,R286,R287,R344,R345,R346,R347,R144,R145,R146,R147,R227,R226,R225,R224,R291,R290,R289,R288,R372 | 1206 | 181 | ?
11 | 1.5K | R1,R2,R3,R4,R5,R6,R7,R8 | R0603 | 8 | RMC06031.5K1%N | Tyohm | LCSC | C269443
12 | max7219cng | U8 | DIP-24_L31.7-W6.6-P1.27-LS7.62-BL | 1 | max7219cng | MAXIM | LCSC | C29160
13 | 32.768KHz | X1 | OSC-TH_BD3.1-P0.8-D0.3 | 1 | AB38T-32.768KHZ | Abracon LLC | LCSC | C194002
14 | FMMT491TA | Q7,Q8,Q9,Q10,Q11,Q12,Q13,Q14 | SOT-23-3_L2.9-W1.6-P1.90-LS2.8-BR | 8 | FMMT491TA | Diodes Incorporated | LCSC | C141788 | Yes
15 | 100n | C9 | RAD-0.1 | 1
16 | 10u | C8 | RAD-0.1 | 1
