Ibrashige/Sunstation/Research/Firmware/Clock Circuit/Arduino-Real-Time-Clock-DS1307-Tutorial-Circuit-2.jpg

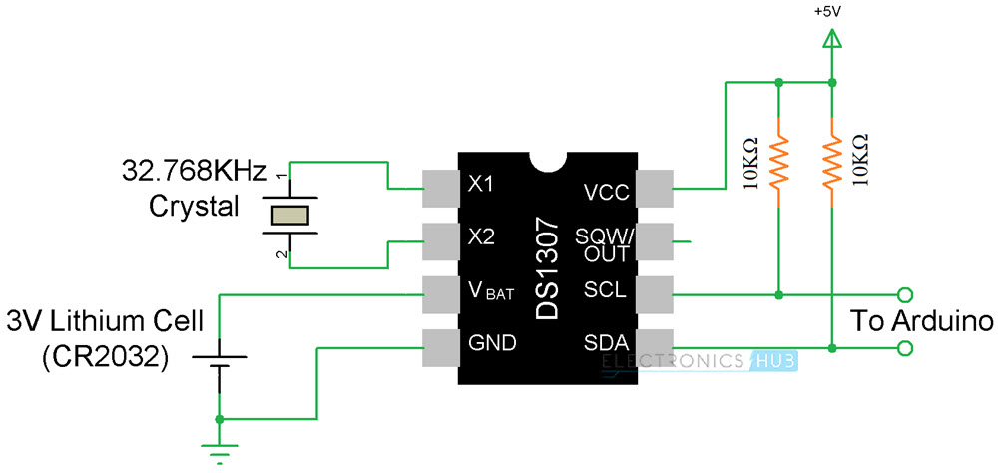
Research/Firmware/Clock Circuit/Arduino-Real-Time-Clock-DS1307-Tutorial-Circuit-2.jpg
