Ibrashige/Sunstation/PCB Design & Schematics/Base model Design & Schematics/Schematic_Final base model_2021-08-13.pdf

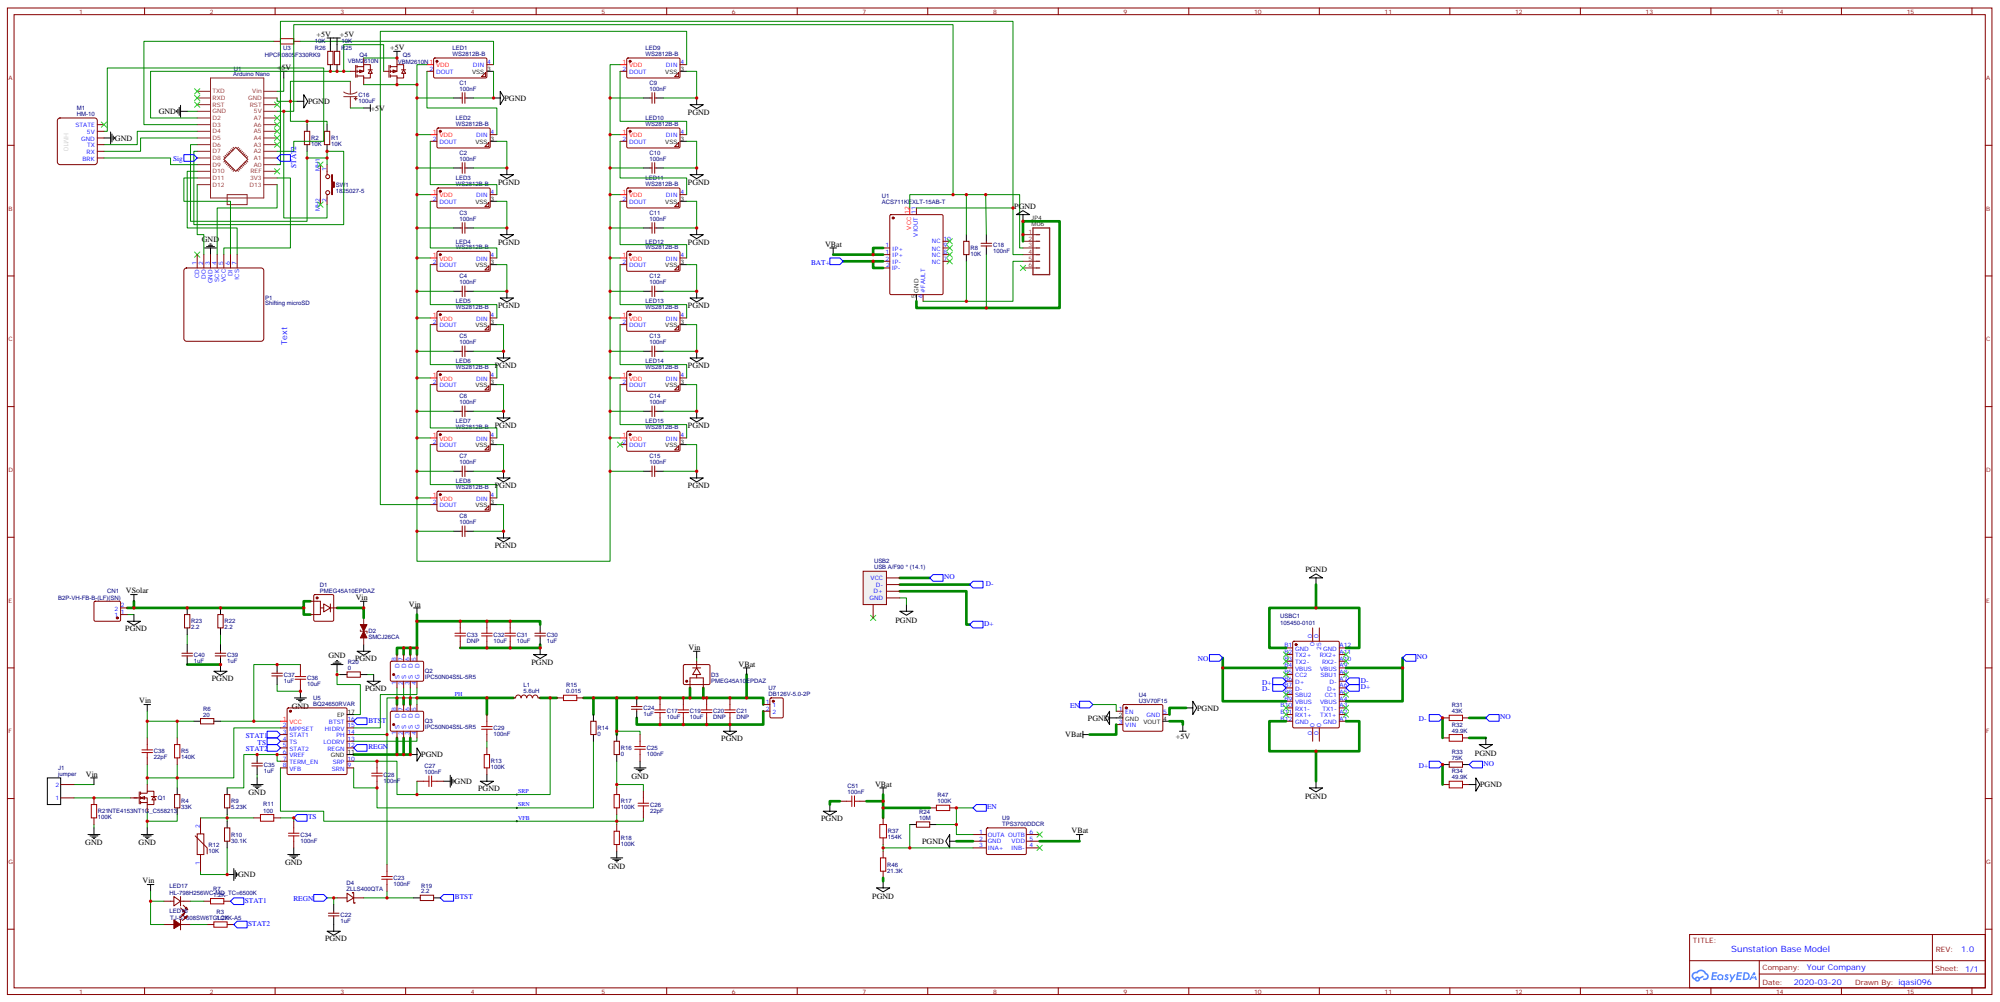
[picture p15: page 1]

SRP 10 GND 11 REGN 12 LODRV 13 PH 14 HIDRV 15 BTST 16 EP 17
