Ibrashige/Sunstation/PCB Design & Schematics/Base model Design & Schematics/(Back) PCB_Final base model with USB-C Layout_2021-08-13.pdf

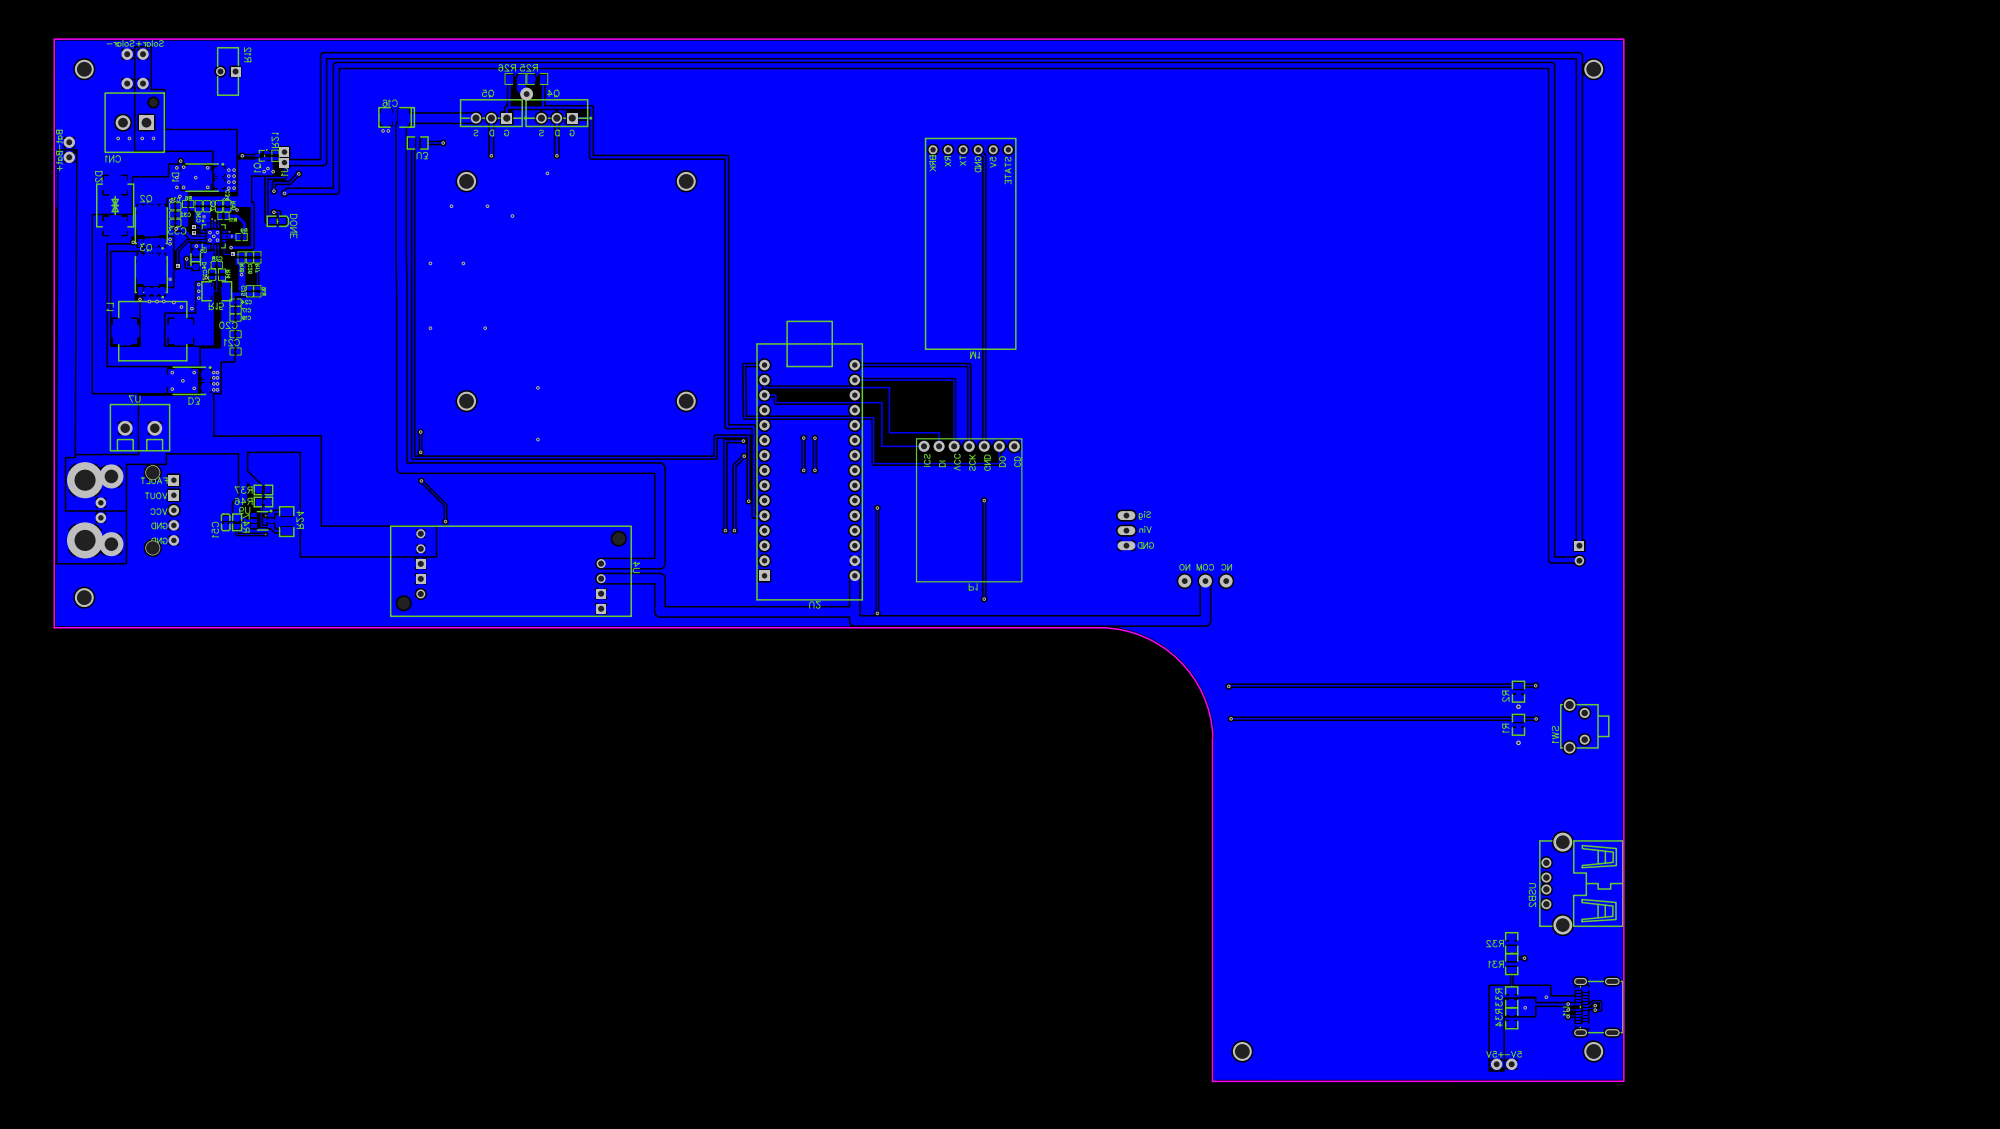
[picture p16: page 1]
