Ibrashige/Sunstation/PCB Design & Schematics/Base model Design & Schematics/(Front) PCB_Final base model with USB-C Layout_2021-08-13.pdf

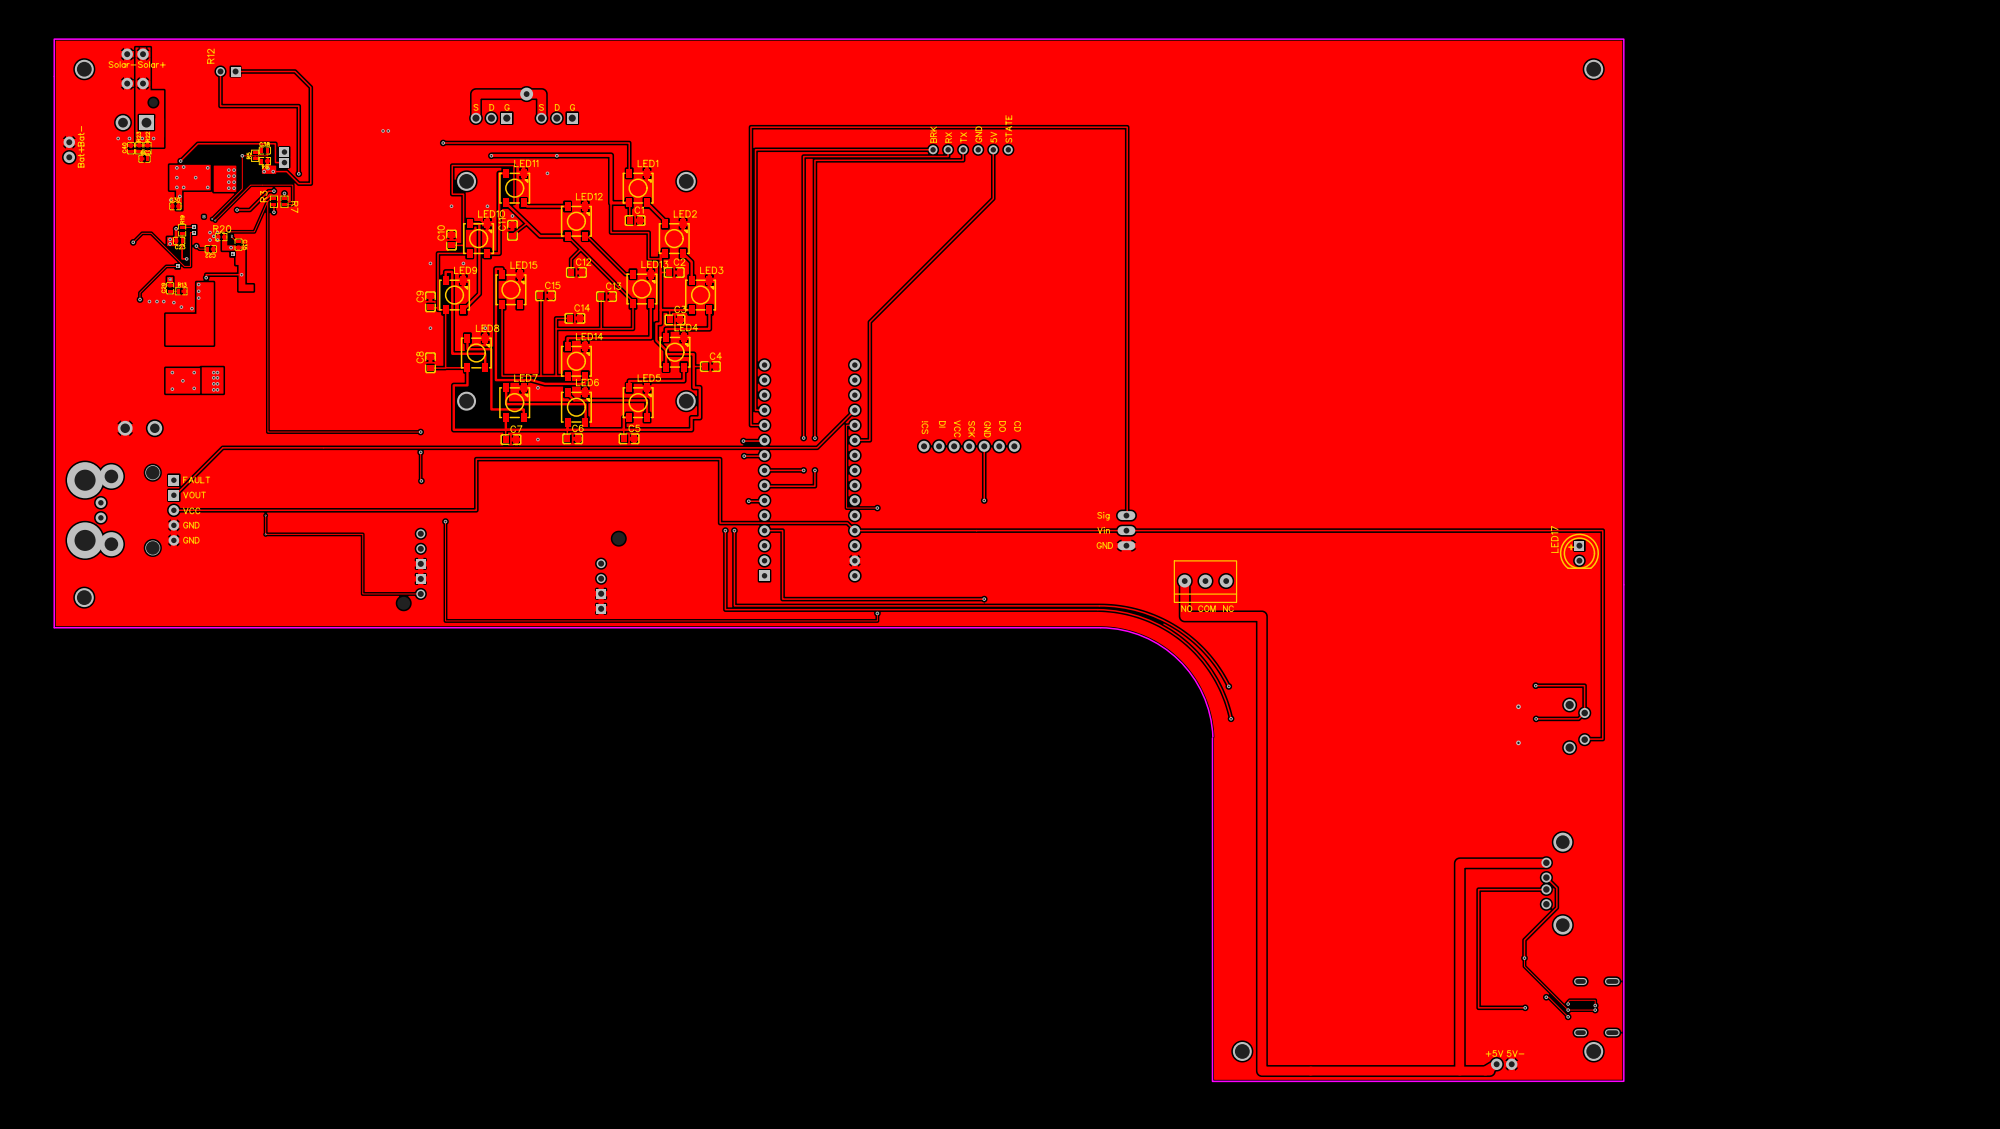
[picture p17: page 1]
